micksuffolk/Microchip_PWM_Motor_Controller/Gerber/Mechanical 1.TXT

G04 PROTEUS RS274X GERBER FILE*
%FSLAX24Y24*%
%MOIN*%
%ADD21C,0.0080*%
G54D21*
X-31496Y-19685D02*
X+31496Y-19685D01*
X+31496Y+19685D01*
X-31496Y+19685D01*
X-31496Y-19685D01*
M00*
