micksuffolk/Microchip_PWM_Motor_Controller/Bottom Silk.png

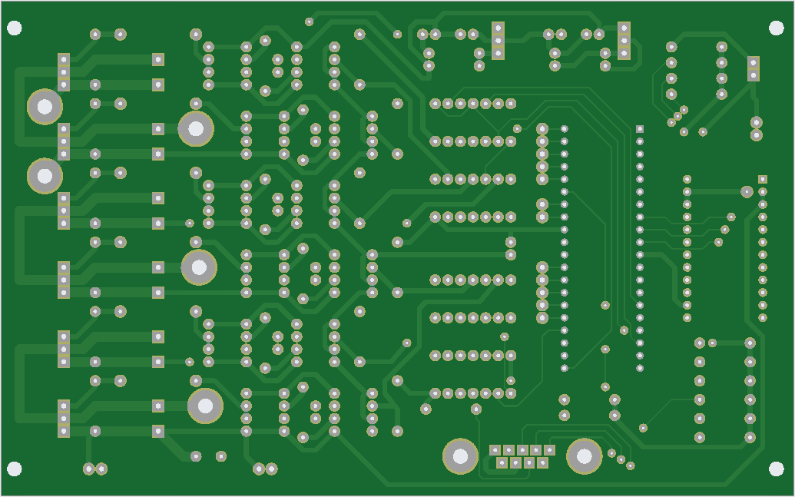
Bottom Silk.png
