micksuffolk/Microchip_PWM_Motor_Controller/Top Silk.png

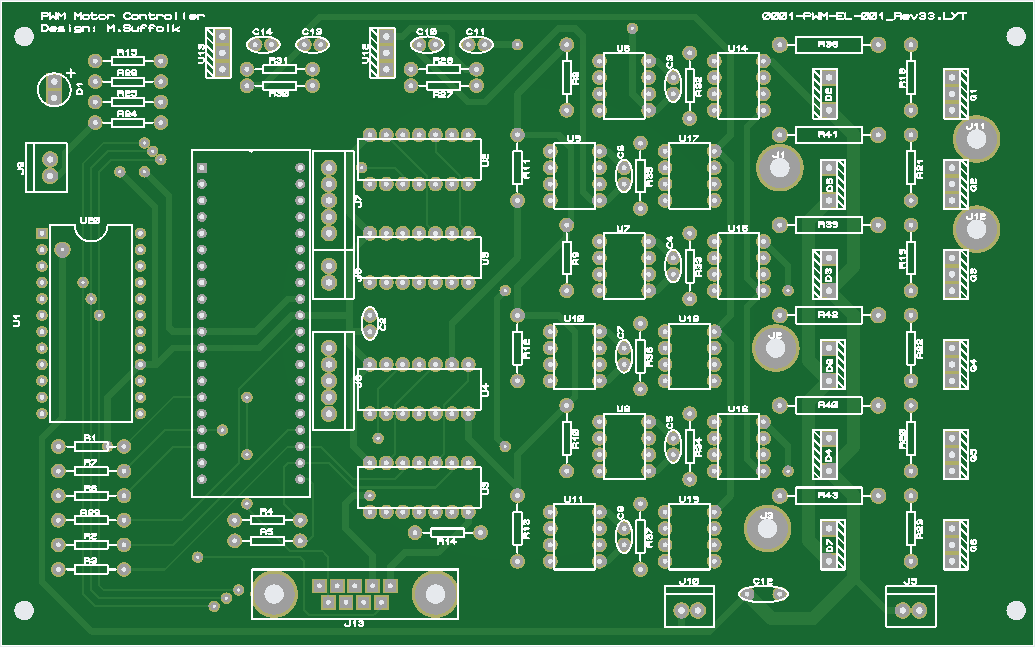
Top Silk.png
