micksuffolk/Microchip_PWM_Motor_Controller/Gerber/Bottom Solder Resist.TXT

G04 PROTEUS RS274X GERBER FILE*
%FSLAX24Y24*%
%MOIN*%
%ADD17C,0.0700*%
%ADD23C,0.1000*%
%ADD24R,0.1000X0.1000*%
%ADD25C,0.0900*%
%ADD26C,0.2900*%
%ADD19R,0.0600X0.0600*%
%ADD70C,0.0600*%
%ADD20R,0.0700X0.0700*%
%ADD27R,0.0900X0.0900*%
%ADD21C,0.0080*%
G54D17*
X+16500Y-9000D03*
X+16500Y+2000D03*
X-25000Y-7500D03*
G54D23*
X-27750Y+4500D03*
G54D17*
X+0Y+17000D03*
X+7000Y+18000D03*
X-22750Y+11000D03*
X-22250Y+10500D03*
X-21750Y+10000D03*
X-24250Y+9250D03*
X-9000Y-10500D03*
X-8500Y-7000D03*
X-19500Y-14250D03*
X-750Y+2000D03*
X-750Y-7500D03*
X-17000Y-16250D03*
X-17750Y-16750D03*
X-18500Y-17250D03*
X-16500Y-4500D03*
X-16500Y-8000D03*
X-16500Y-11000D03*
X-9500Y+9500D03*
X-18000Y-6500D03*
X-26500Y+2500D03*
X-26000Y+1500D03*
X-25500Y+500D03*
X-22750Y+9250D03*
G54D24*
X+26500Y+15000D03*
X+26500Y+14000D03*
X+26500Y+13000D03*
X+26500Y+9500D03*
X+26500Y+8500D03*
X+26500Y+7500D03*
X+26500Y+4000D03*
X+26500Y+3000D03*
X+26500Y+2000D03*
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
