micksuffolk/Microchip_PWM_Motor_Controller/Schematic.PDF

U1

U2

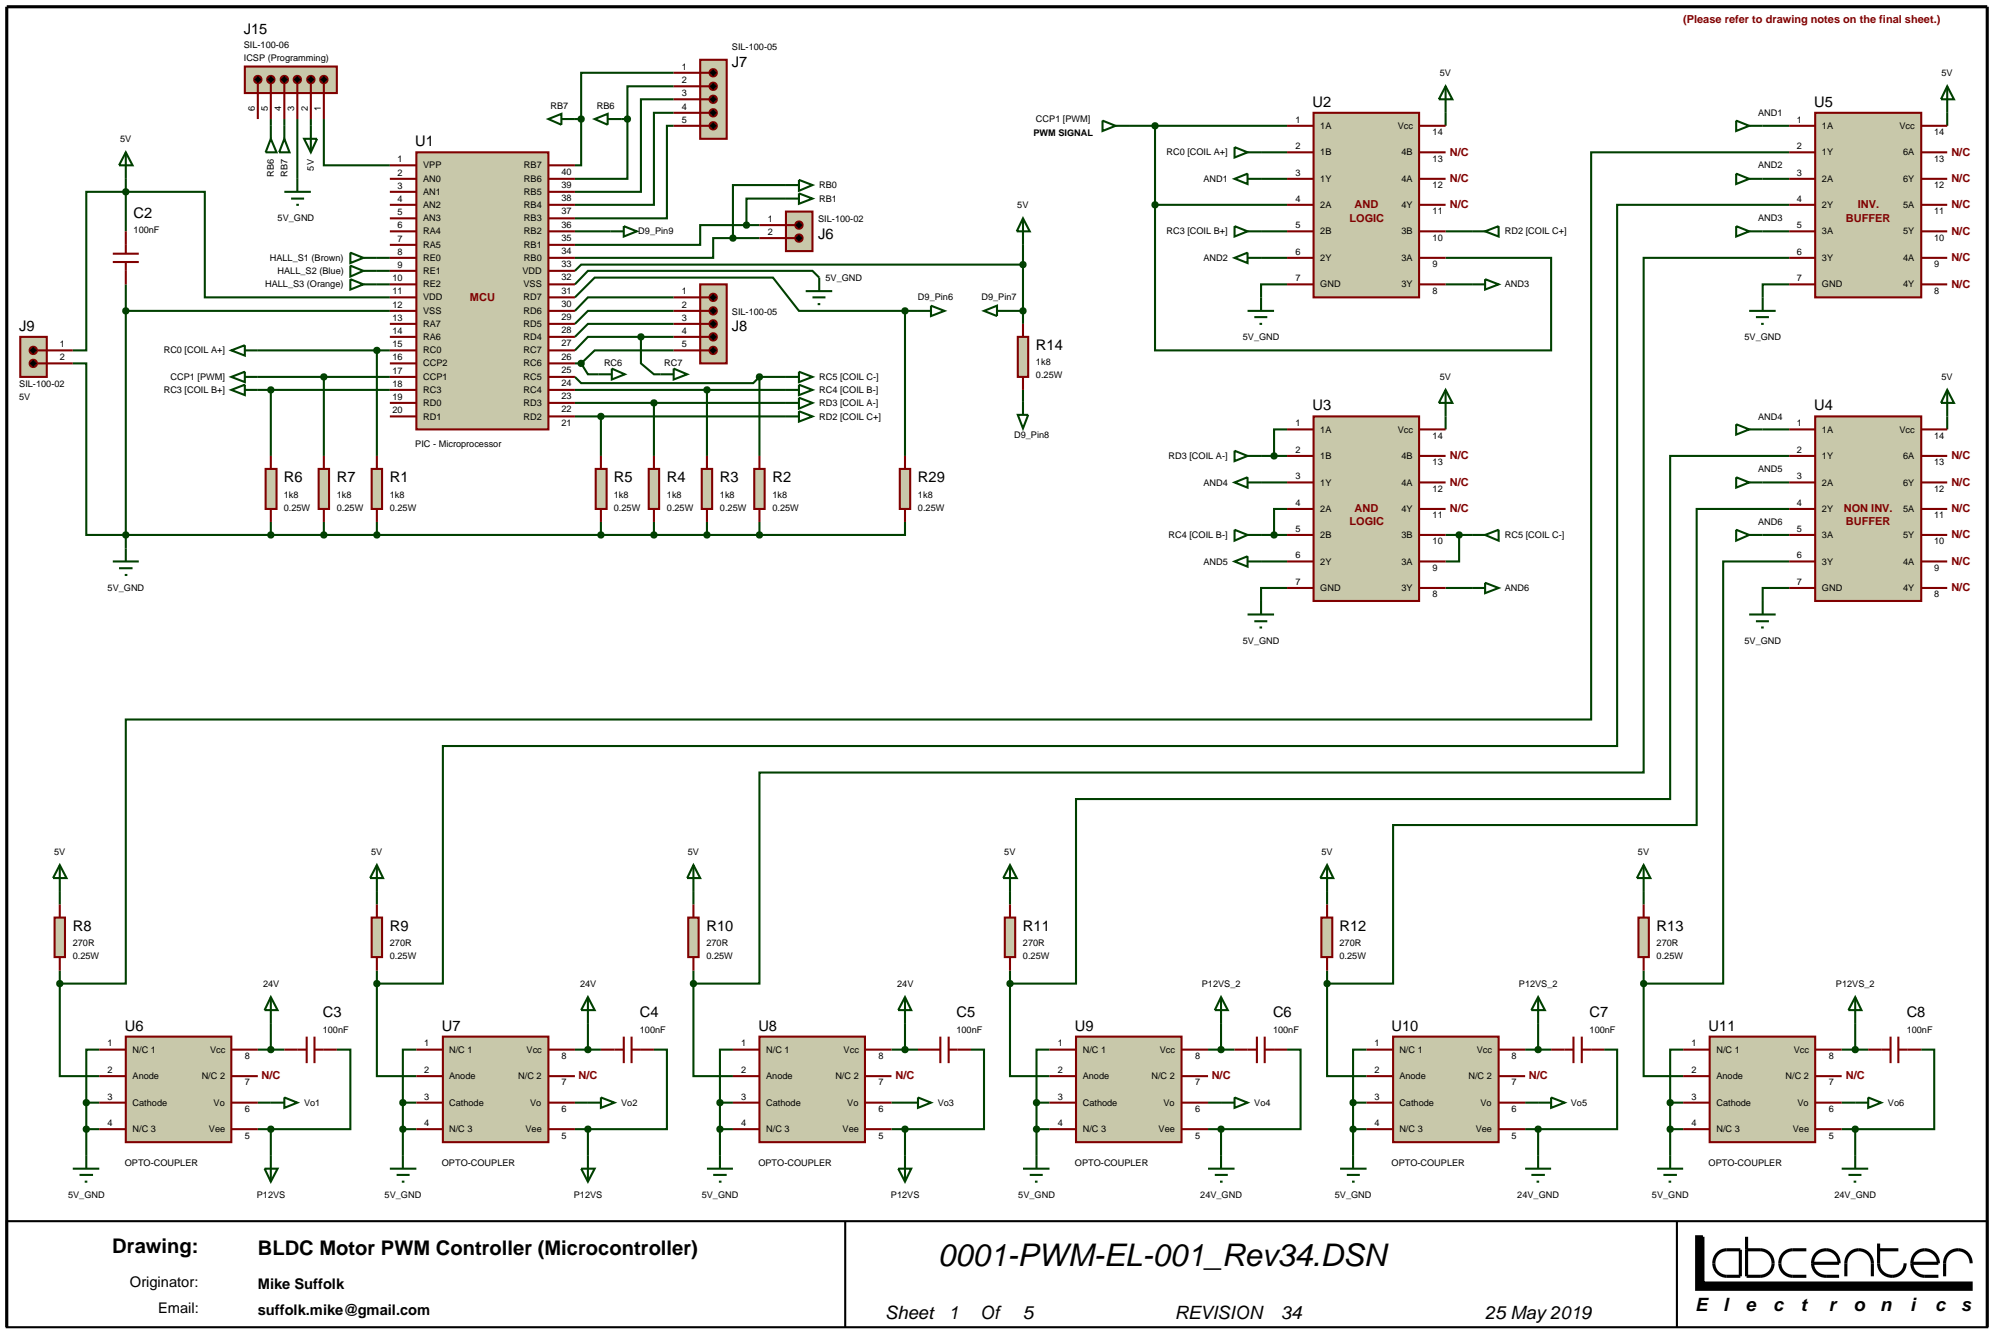
[picture p3: page 1]

(Please refer to drawing notes on the final sheet.)

R32

R33

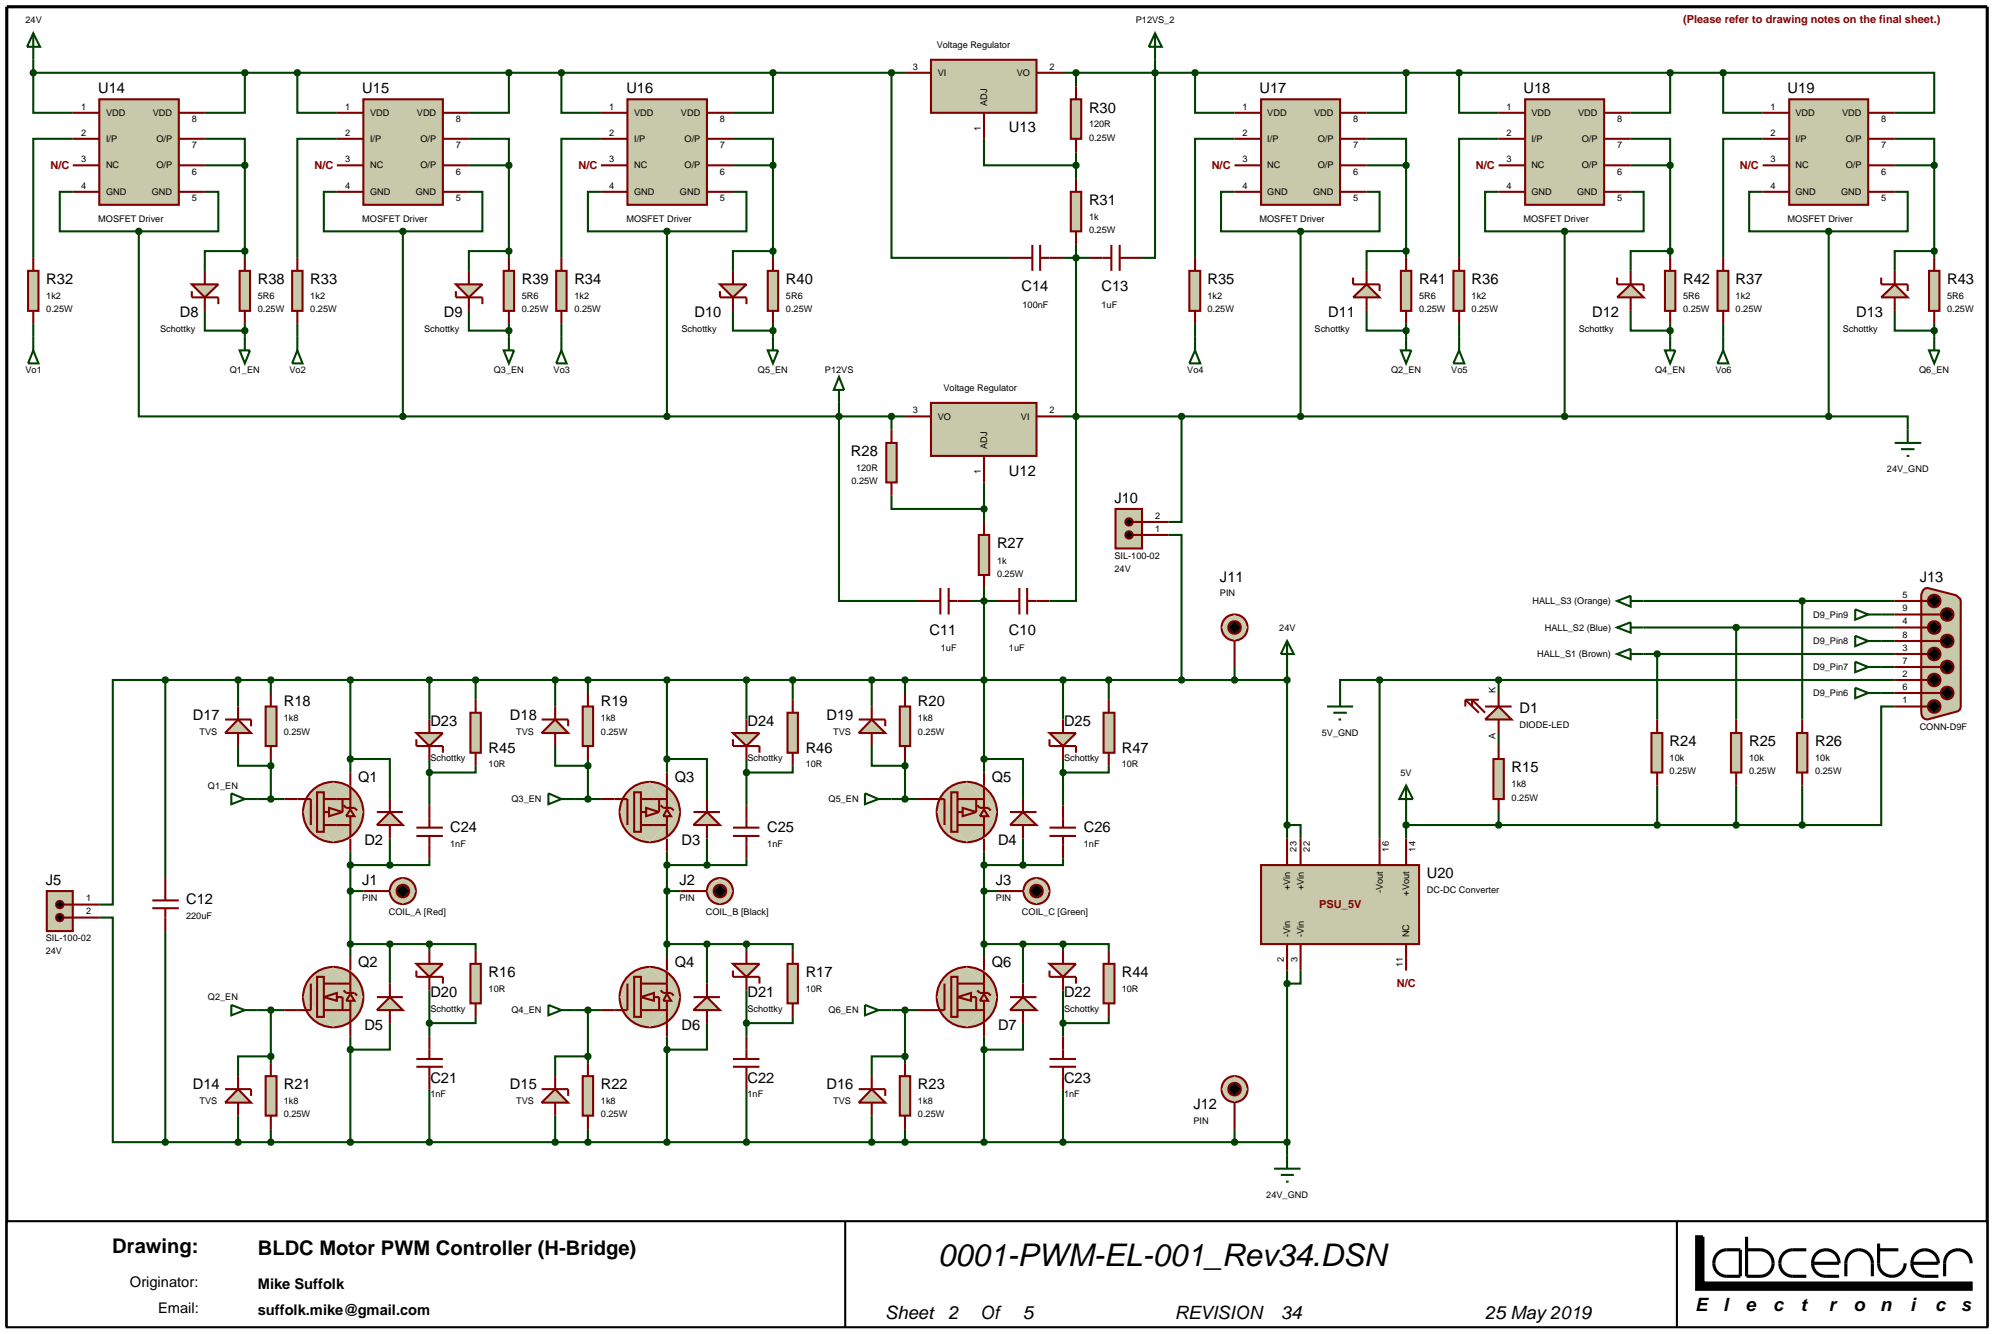
[picture p4: page 2]

R30 VDD 1 | VDD 1

J4

RV1

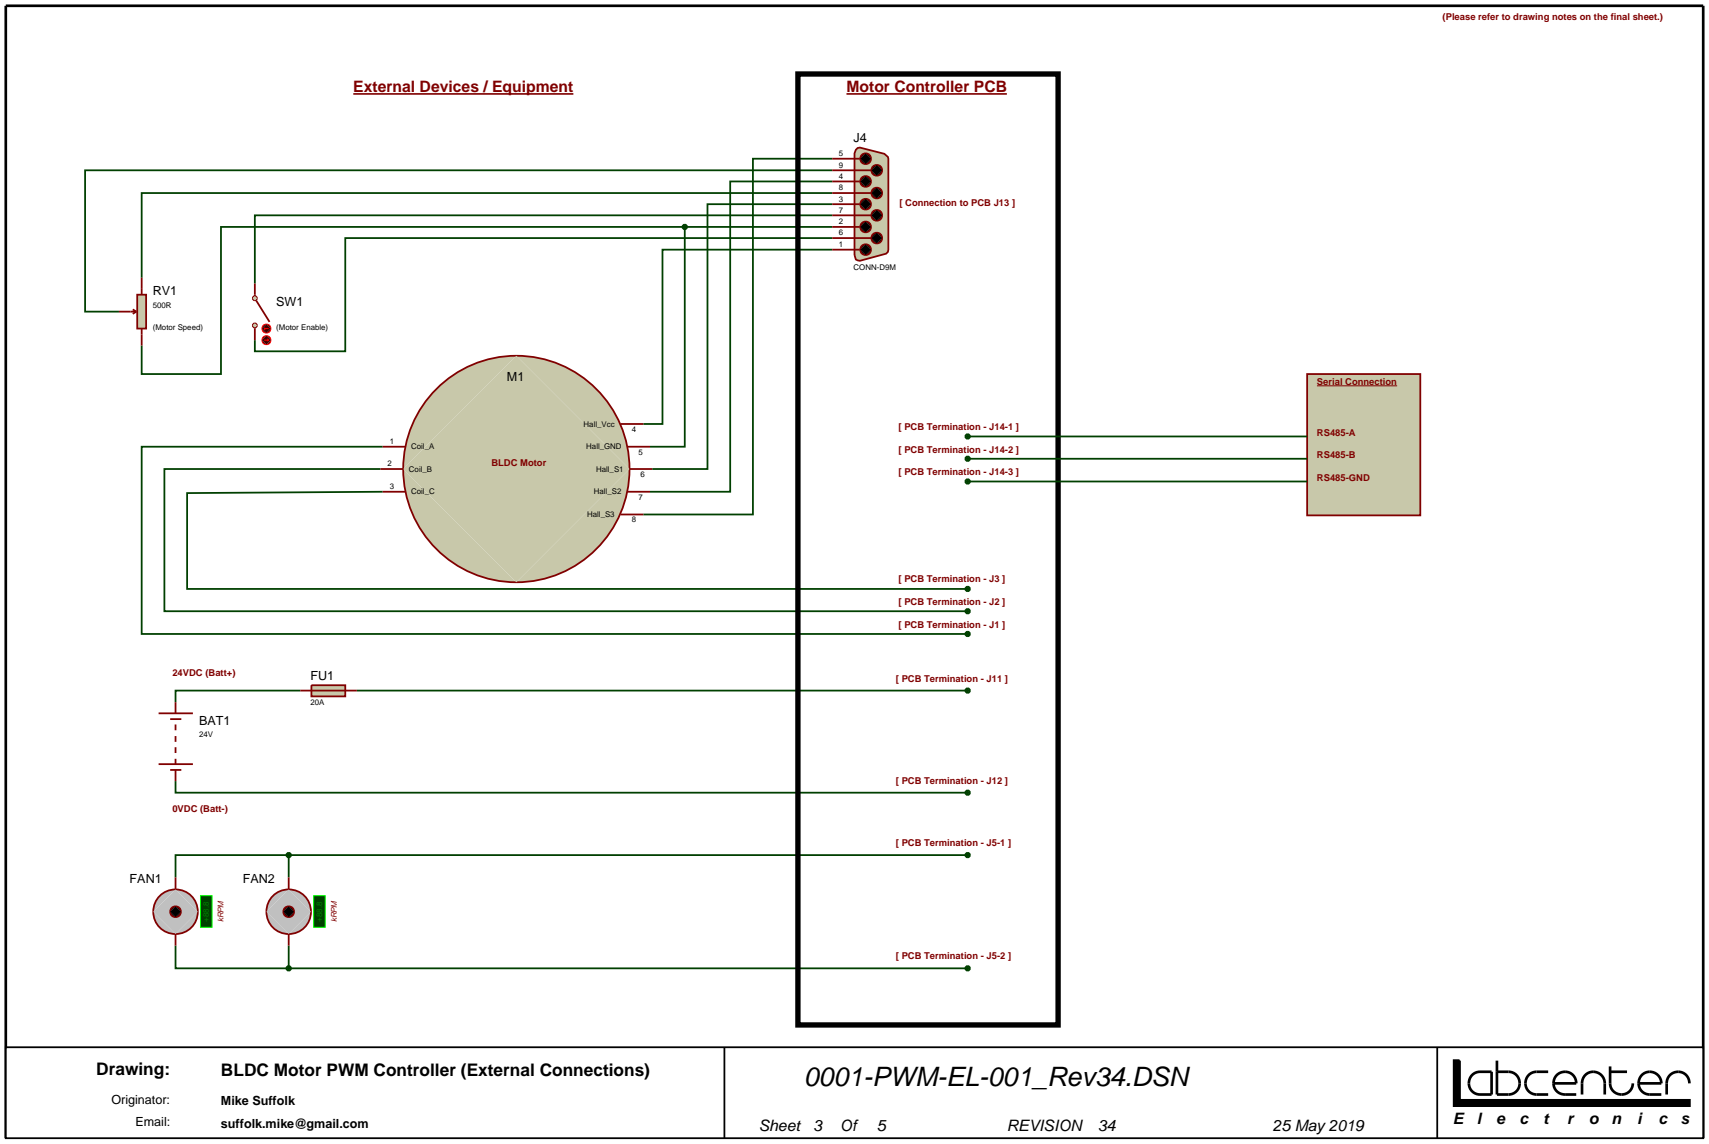
[picture p5: page 3]
CONN-D9M; (Motor Speed); (Motor Enable); [ PCB Termination - J11 ]; [ PCB Termination - J12 ]; 24VDC (Batt+); 0VDC (Batt-); BLDC Motor Coil_B 2; Coil_A 1; Coil_C 3; Hall_S1; Hall_GND; Hall_Vcc; Hall_S2; Hall_S3; BAT1; [ PCB Termination - J1 ]; [ PCB Termination - J2 ]; [ PCB Termination - J3 ]; Drawing:; BLDC Motor PWM Controller (External Connections); 0001-PWM-EL-001_Rev34.DSN; kRPM; FAN1; FAN2; [ PCB Termination - J5-1 ]; [ PCB Termination - J5-2 ]; [ PCB Termination - J14-3 ]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

External Devices / Equipment

Motor Controller PCB

[ Connection to PCB J13 ]

Drawing Notes.

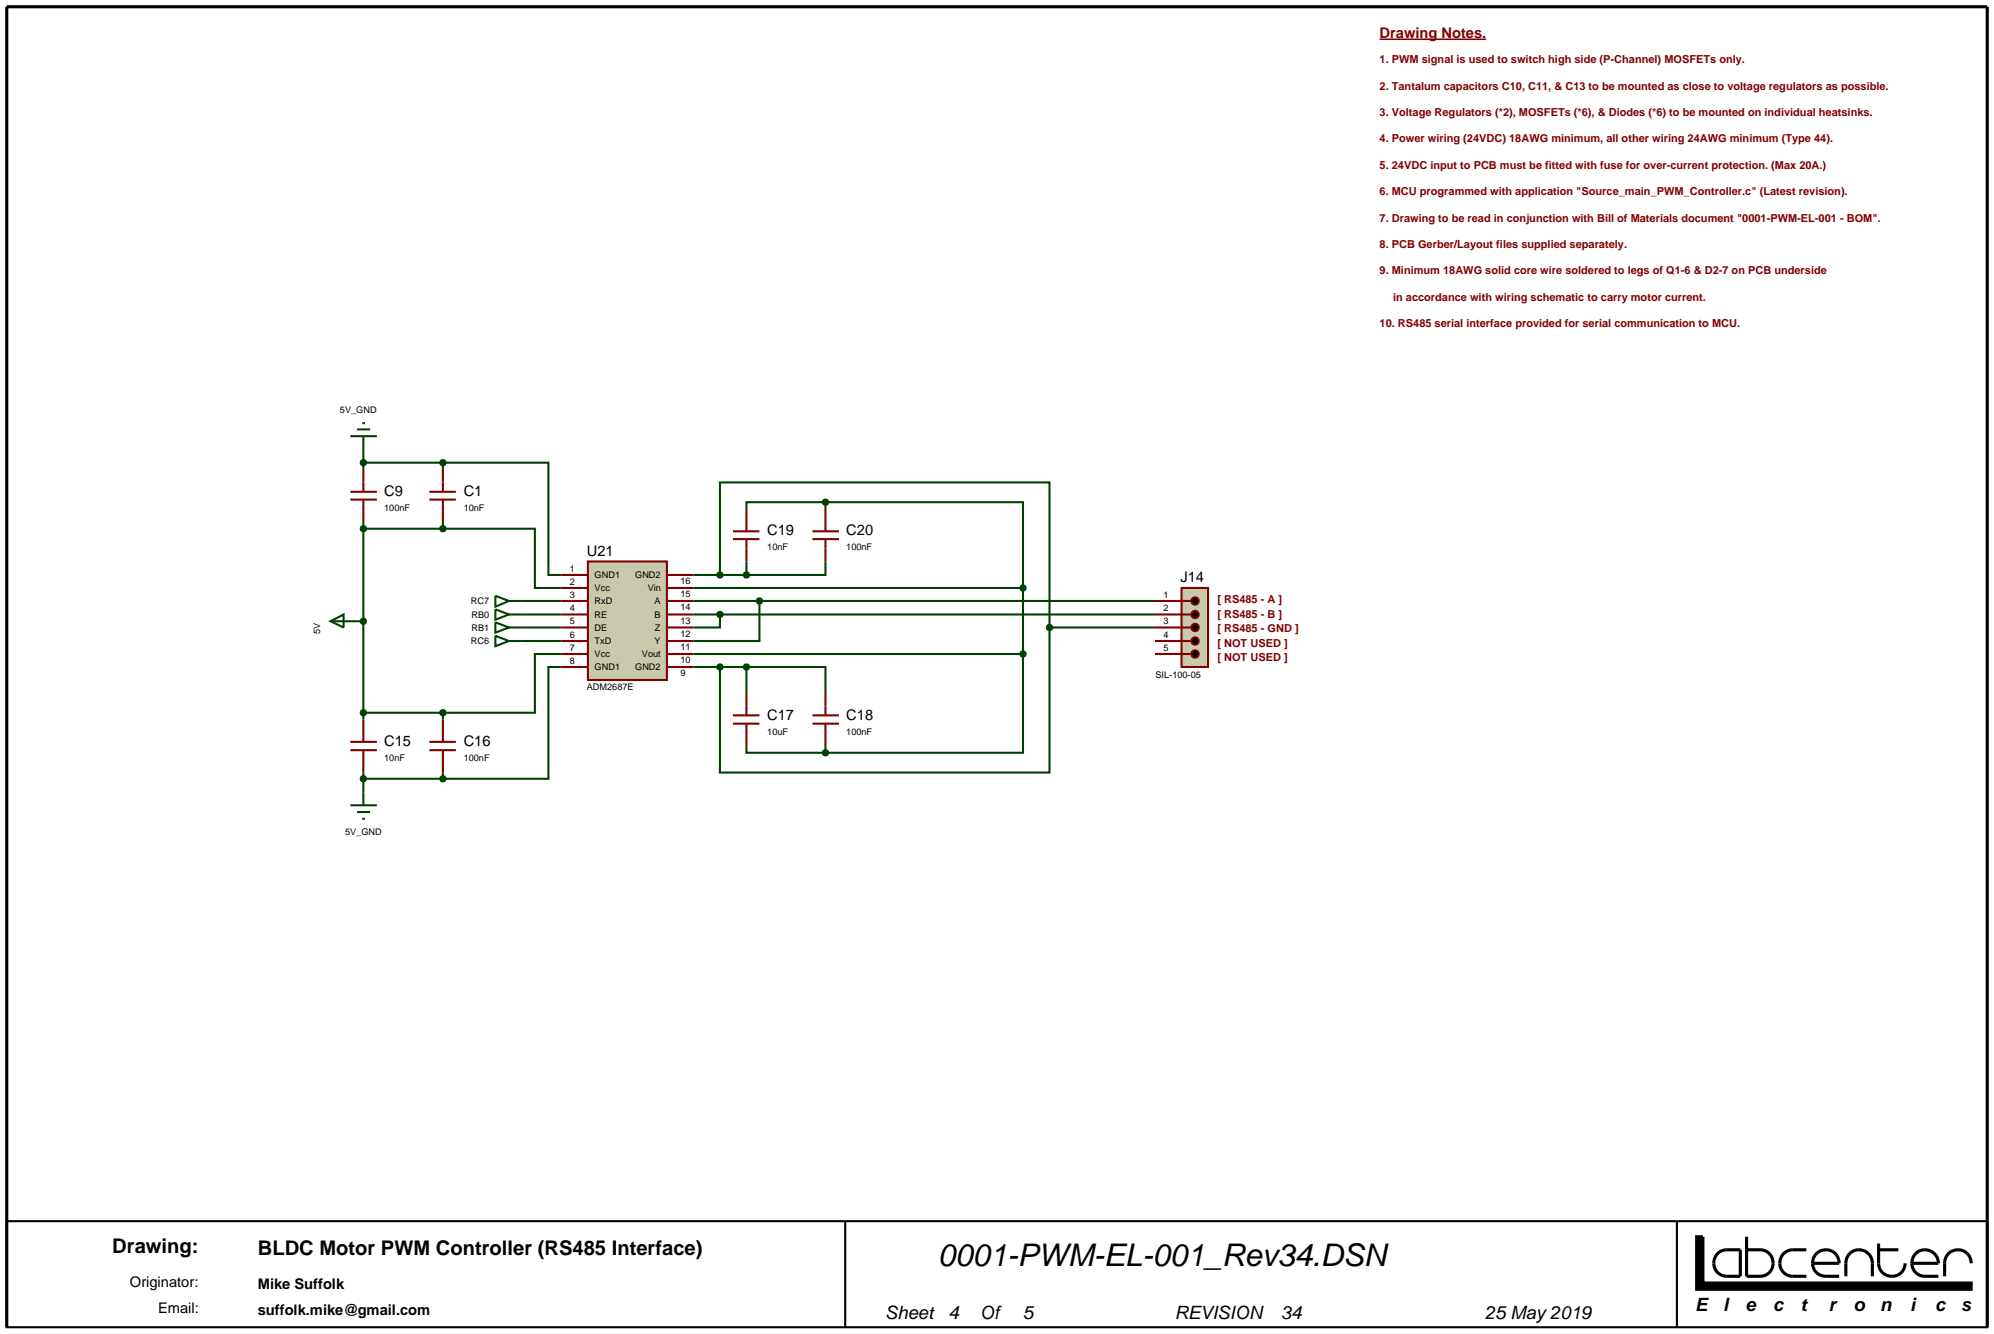
[picture p6: page 4]

1. PWM signal is used to switch high side (P-Channel) MOSFETs only.

2. Tantalum capacitors C10, C11, & C13 to be mounted as close to voltage regulators as possible.

3. Voltage Regulators (*2), MOSFETs (*6), & Diodes (*6) to be mounted on individual heatsinks.

4. Power wiring (24VDC) 18AWG minimum, all other wiring 24AWG minimum (Type 44).

5. 24VDC input to PCB must be fitted with fuse for over-current protection. (Max 20A.)

6. MCU programmed with application "Source_main_PWM_Controller.c" (Latest revision).

7. Drawing to be read in conjunction with Bill of Materials document "0001-PWM-EL-001 - BOM".

8. PCB Gerber/Layout files supplied separately.

9. Minimum 18AWG solid core wire soldered to legs of Q1-6 & D2-7 on PCB underside

in accordance with wiring schematic to carry motor current.

10. RS485 serial interface provided for serial communication to MCU.

J17

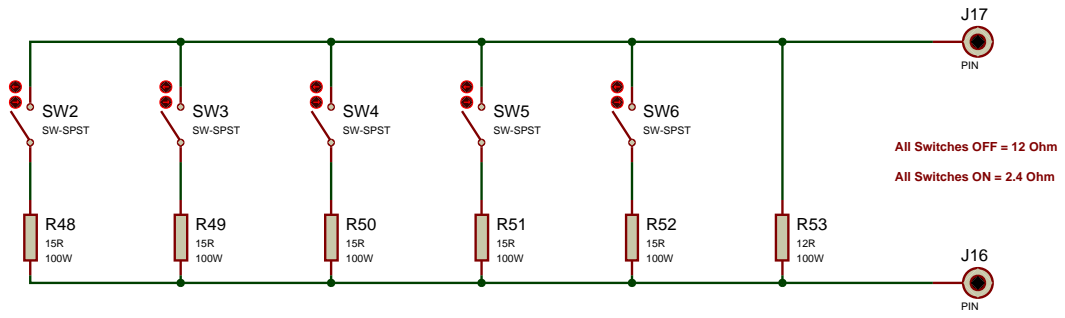
[picture p7: page 5]

All Switches OFF = 12 Ohm

All Switches ON = 2.4 Ohm
