micksuffolk/Microchip_PWM_Motor_Controller/Board layout.pdf

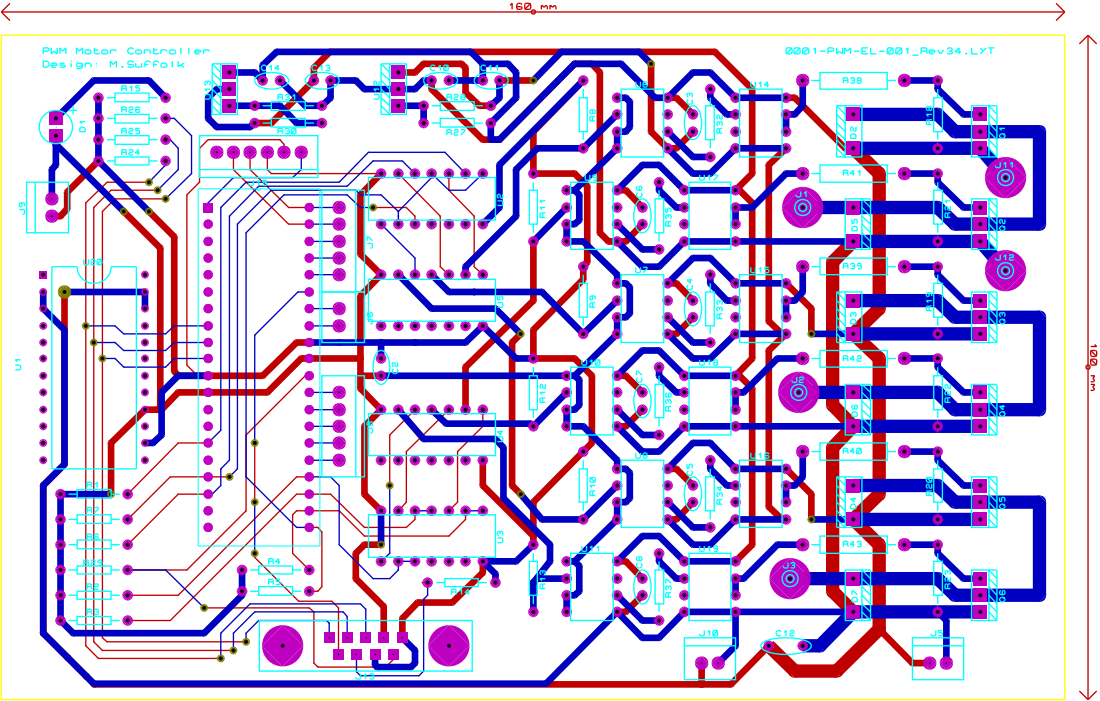
[picture p8: page 1]
