micksuffolk/Microchip_PWM_Motor_Controller/(list of files, drawings)

Other design files:
Board layout.LYT
Schematic.DSN
