micksuffolk/Microchip_PWM_Motor_Controller/(commit log)

2023-08-12 Design files updated as-built
    [Bill of materials.csv, Board layout.LYT, Schematic.DSN]
2023-08-12 Added gerber
